BSides-CT/2020-Badge/Hardware/Schematics/bsidesct2019.kicad_pcb

## KiCad design Hardware/Schematics/bsidesct2019.kicad_pcb (2020-11-04)

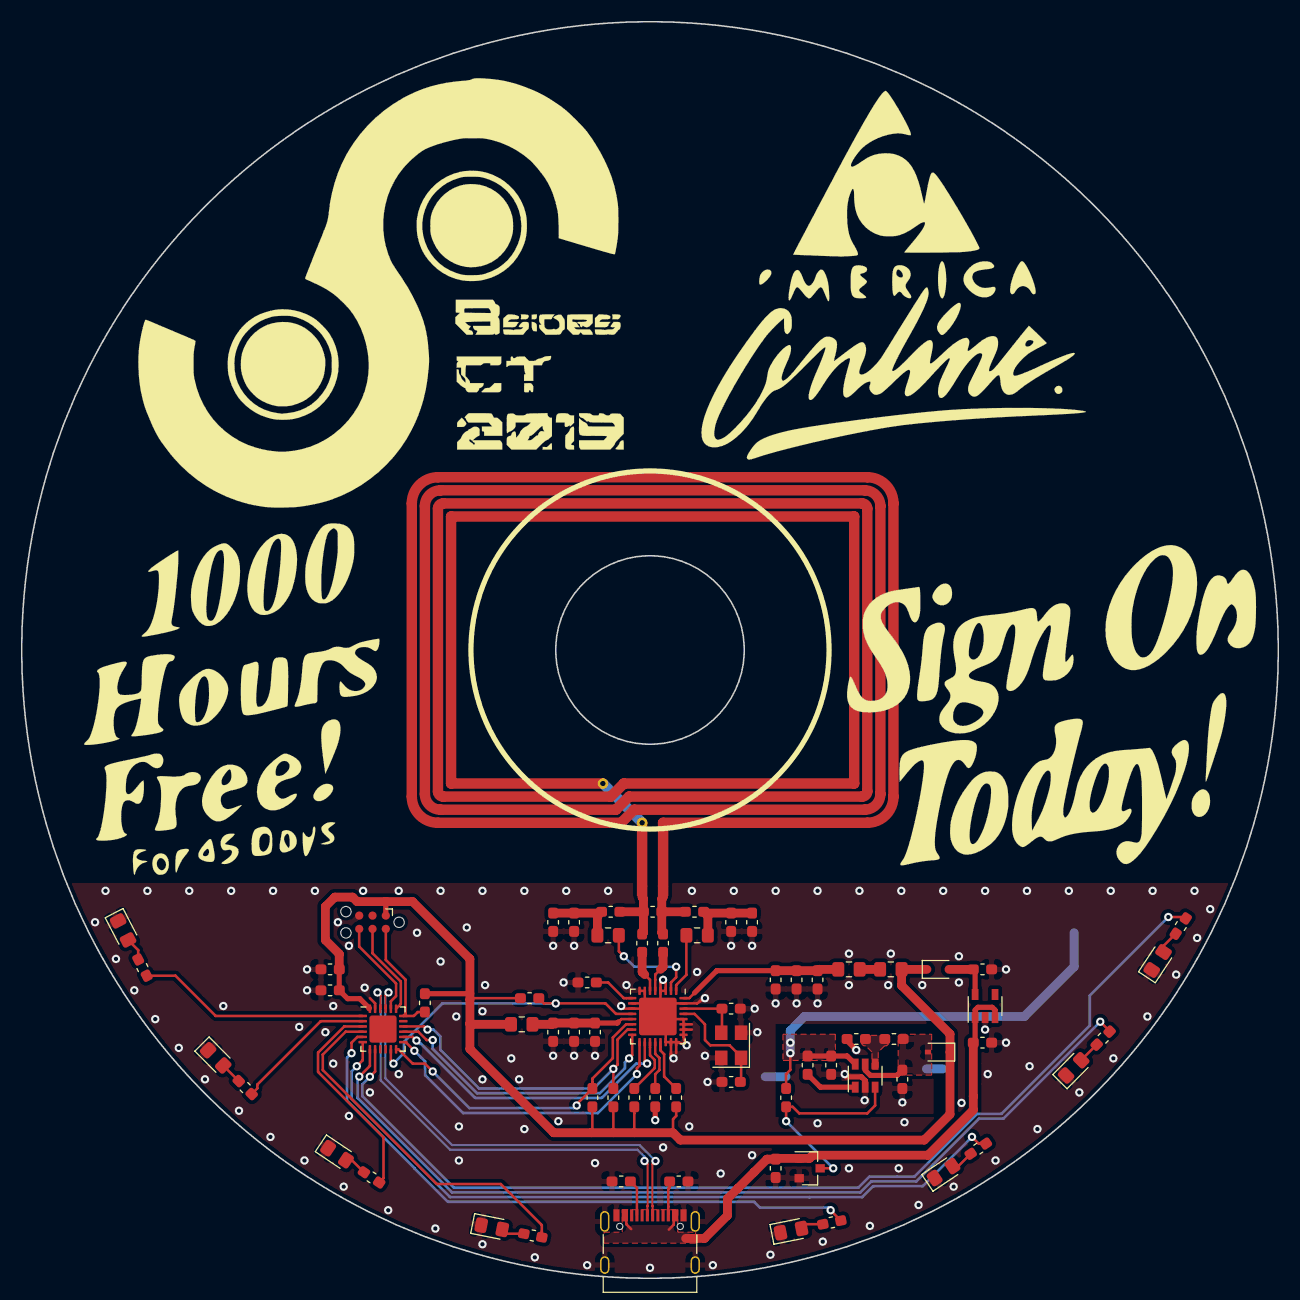
[picture p8: board bsidesct2019.kicad_pcb from above]

Board: 2 copper layers, 120.0 x 120.0 mm, 75 parts (1 on the bottom side), 55 nets.

Parts:
AE1: Antenna; CR95HF-antenna
C1, C2, C18, C21, C22: 1uF; C_0603_1608Metric_Pad1.05x0.95mm_HandSolder
C3, C4, C10: 0.1uF; C_0603_1608Metric_Pad1.05x0.95mm_HandSolder
C5, C9: 10pF; C_0603_1608Metric_Pad1.05x0.95mm_HandSolder
C6, C7: 10nF; C_0603_1608Metric_Pad1.05x0.95mm_HandSolder
C8: 1nF; C_0603_1608Metric_Pad1.05x0.95mm_HandSolder
C11, C12, C13, C14: 100pF; C_0603_1608Metric_Pad1.05x0.95mm_HandSolder
C15, C16: 47pF; C_0603_1608Metric_Pad1.05x0.95mm_HandSolder
C17: 82pF; C_0603_1608Metric_Pad1.05x0.95mm_HandSolder
C19: 4.7uF; C_0603_1608Metric_Pad1.05x0.95mm_HandSolder
C20: 10uF; C_0603_1608Metric_Pad1.05x0.95mm_HandSolder
D1, D10: CUS10S30,H3F; D_SOD-323
D2, D3, D4, D5, D6, D7, D8, D9: LED; LED_0805_2012Metric_Pad1.15x1.40mm_HandSolder
J1: TC2030; Tag-Connect_TC2030-IDC-NL_2x03_P1.27mm_Vertical
L1, L2, L3: 742792042; L_0805_2012Metric_Pad1.15x1.40mm_HandSolder
L4, L5: 560nH; L_0805_2012Metric_Pad1.15x1.40mm_HandSolder
L6: 4.7uH; L_0603_1608Metric_Pad1.05x0.95mm_HandSolder
P1: USB_C_Plug_USB2.0; USB_C_Receptacle_Palconn_UTC16-G
Q1: 2N7002; SOT-23
R1, R2, R3, R4, R5, R15: 3.3kΩ; R_0603_1608Metric_Pad1.05x0.95mm_HandSolder
R6, R7: 330Ω; R_0603_1608Metric_Pad1.05x0.95mm_HandSolder
R8, R13, R14: 10kΩ; R_0603_1608Metric_Pad1.05x0.95mm_HandSolder
R9, R10: 5.1kΩ; R_0603_1608Metric_Pad1.05x0.95mm_HandSolder
R11: 976kΩ; R_0603_1608Metric_Pad1.05x0.95mm_HandSolder
R12: 562kΩ; R_0603_1608Metric_Pad1.05x0.95mm_HandSolder
R16, R17, R18, R19, R20, R21, R22, R23: 260Ω; R_0603_1608Metric_Pad1.05x0.95mm_HandSolder
Ref**: Val**; twitter
Ref**#2: Val**; aol_3
Ref**#3: Val**; aol_2
Ref**#4: Val**; aol_1-merica
Ref**#5: Val**; bsidesct.2019.logo.transparent
U1: CR95HF; QFN-32-1EP_5x5mm_P0.5mm_EP3.6x3.6mm
U2: MCP1640BCH; SOT-23-6
U3: ATSAMD11D14A-M; QFN-24-1EP_4x4mm_P0.5mm_EP2.6x2.6mm
U4: MIC5504-3.3YM5-TR; SOT-23-5
Y1: 27.12MHz; Crystal_SMD_SeikoEpson_FA238V-4Pin_3.2x2.5mm

Connections:
+3V3: C10.1, C18.1, D1.1, D10.1, J1.1, L1.1, L3.1, R1.1, R2.1, R3.1, R5.1, R8.1, R15.1, U3.24
+5V: C21.1, P1.A4, P1.A9, P1.B4, P1.B9, Q1.1, R13.1, U4.1, U4.3
+BATT: C19.1, L6.1, R14.1, U2.6
/D+: P1.A6, U3.22
/D-: P1.A7, U3.21
/L0: R16.2, U3.1
/L1: R17.2, U3.2
/L2: R18.2, U3.3
/L3: R19.2, U3.4
/L4: R20.1, U3.5
/L5: R21.1, U3.6
/L6: R22.1, U3.7
/L7: R23.1, U3.8
/MISO: U1.16, U3.15
/MOSI: U1.17, U3.13
/RX: R3.2, U1.14, U3.12
/SCK: U1.18, U3.14
/SS: R15.2, U1.15, U3.16
/TX: R2.2, U1.12, U3.11
GND: C1.2, C2.2, C3.2, C4.2, C5.2, C6.2, C7.2, C8.1, C9.2, C10.2, C11.2, C12.1, C13.2, C14.1, C18.2, C19.2, C20.2, C21.2, C22.2, D2.1, D3.1, D4.1, D5.1, D6.1, D7.1, D8.1, D9.1, J1.5, P1.A1, P1.A12, P1.B1, P1.B12, P1.S1, Q1.2, R4.1, R9.2, R10.2, R12.2, R13.2, U1.3, U1.4, U1.7, U1.8, U1.10, U1.11, U1.22, U1.23, U1.24, U1.25, U1.26, U1.27, U1.28, U1.31, U1.33, U2.2, U3.23, U4.2, Y1.2, Y1.4
unnamed: AE1.1, C15.2, C17.1, R6.1
unnamed: AE1.2, C16.2, C17.2, R7.1
unnamed: C1.1, C3.1, C6.1, L2.2, U1.32
unnamed: C2.1, C4.1, C7.1, L3.2, U1.13
unnamed: C5.1, U1.29, Y1.1
unnamed: C8.2, U1.9
unnamed: C9.1, U1.30, Y1.3
unnamed: C11.1, C13.1, C15.1, L4.2
unnamed: C12.2, C14.2, C16.1, L5.2
unnamed: C20.1, D1.2, R11.1, U2.5
unnamed: C22.1, D10.2, U4.5
unnamed: D2.2, R16.1
unnamed: D3.2, R17.1
unnamed: D4.2, R18.1
unnamed: D5.2, R19.1
unnamed: D6.2, R20.2
unnamed: D7.2, R21.2
unnamed: D8.2, R22.2
unnamed: D9.2, R23.2
unnamed: J1.2, R8.2, U3.18
unnamed: J1.4, U3.19
unnamed: J1.6, U3.20
unnamed: L1.2, L2.1
unnamed: L4.1, U1.1
unnamed: L5.1, U1.2
unnamed: L6.2, U2.1
unnamed: P1.A5, R9.1
unnamed: P1.B5, R10.1
unnamed: Q1.3, R14.2, U2.3
unnamed: R1.2, U1.19
unnamed: R4.2, U1.20
unnamed: R5.2, U1.21
unnamed: R6.2, U1.5
unnamed: R7.2, U1.6
unnamed: R11.2, R12.1, U2.4
