BSides-CT/2020-Badge/Software/NFCBadge/NFCBadge/driver_init.c

/*
 * Code generated from Atmel Start.
 *
 * This file will be overwritten when reconfiguring your Atmel Start project.
 * Please copy examples or other code you want to keep to a separate file
 * to avoid losing it when reconfiguring.
 */

#include "driver_init.h"
#include <peripheral_clk_config.h>
#include <utils.h>
#include <hal_init.h>
#include <hpl_gclk_base.h>
#include <hpl_pm_base.h>

struct spi_m_sync_descriptor SPI_0;
struct timer_descriptor      TIMER_0;

void EXTERNAL_IRQ_0_init(void)
{
	_gclk_enable_channel(EIC_GCLK_ID, CONF_GCLK_EIC_SRC);

	// Set pin direction to input
	gpio_set_pin_direction(IRQ_IN, GPIO_DIRECTION_IN);

	gpio_set_pin_pull_mode(IRQ_IN,
	                       // <y> Pull configuration
	                       // <id> pad_pull_config
	                       // <GPIO_PULL_OFF"> Off
	                       // <GPIO_PULL_UP"> Pull-up
	                       // <GPIO_PULL_DOWN"> Pull-down
	                       GPIO_PULL_OFF);

	gpio_set_pin_function(IRQ_IN, PINMUX_PA15A_EIC_EXTINT1);

	ext_irq_init();
}

void SPI_0_PORT_init(void)
{

	gpio_set_pin_level(SPI_MISO,
	                   // <y> Initial level
	                   // <id> pad_initial_level
	                   // <false"> Low
	                   // <true"> High
	                   false);

	// Set pin direction to output
	gpio_set_pin_direction(SPI_MISO, GPIO_DIRECTION_OUT);

	gpio_set_pin_function(SPI_MISO, PINMUX_PA22C_SERCOM1_PAD0);

	// Set pin direction to input
	gpio_set_pin_direction(SPI_MOSI, GPIO_DIRECTION_IN);

	gpio_set_pin_pull_mode(SPI_MOSI,
	                       // <y> Pull configuration
	                       // <id> pad_pull_config
	                       // <GPIO_PULL_OFF"> Off
	                       // <GPIO_PULL_UP"> Pull-up
	                       // <GPIO_PULL_DOWN"> Pull-down
	                       GPIO_PULL_OFF);

	gpio_set_pin_function(SPI_MOSI, PINMUX_PA16C_SERCOM1_PAD2);

	gpio_set_pin_level(SPI_SCK,
	                   // <y> Initial level
	                   // <id> pad_initial_level
	                   // <false"> Low
	                   // <true"> High
	                   false);

	// Set pin direction to output
	gpio_set_pin_direction(SPI_SCK, GPIO_DIRECTION_OUT);

	gpio_set_pin_function(SPI_SCK, PINMUX_PA17C_SERCOM1_PAD3);
}

void SPI_0_CLOCK_init(void)
{
	_pm_enable_bus_clock(PM_BUS_APBC, SERCOM1);
	_gclk_enable_channel(SERCOM1_GCLK_ID_CORE, CONF_GCLK_SERCOM1_CORE_SRC);
}

void SPI_0_init(void)
{
	SPI_0_CLOCK_init();
	spi_m_sync_init(&SPI_0, SERCOM1);
	SPI_0_PORT_init();
}

void delay_driver_init(void)
{
	delay_init(SysTick);
}

/**
 * \brief Timer initialization function
 *
 * Enables Timer peripheral, clocks and initializes Timer driver
 */
static void TIMER_0_init(void)
{
	_pm_enable_bus_clock(PM_BUS_APBC, TC1);
	_gclk_enable_channel(TC1_GCLK_ID, CONF_GCLK_TC1_SRC);

	timer_init(&TIMER_0, TC1, _tc_get_timer());
}

void USB_DEVICE_INSTANCE_PORT_init(void)
{

	gpio_set_pin_direction(PA24,
	                       // <y> Pin direction
	                       // <id> pad_direction
	                       // <GPIO_DIRECTION_OFF"> Off
	                       // <GPIO_DIRECTION_IN"> In
	                       // <GPIO_DIRECTION_OUT"> Out
	                       GPIO_DIRECTION_OUT);

	gpio_set_pin_level(PA24,
	                   // <y> Initial level
	                   // <id> pad_initial_level
	                   // <false"> Low
	                   // <true"> High
	                   false);

	gpio_set_pin_pull_mode(PA24,
	                       // <y> Pull configuration
	                       // <id> pad_pull_config
	                       // <GPIO_PULL_OFF"> Off
	                       // <GPIO_PULL_UP"> Pull-up
	                       // <GPIO_PULL_DOWN"> Pull-down
	                       GPIO_PULL_OFF);

	gpio_set_pin_function(PA24,
	                      // <y> Pin function
	                      // <id> pad_function
	                      // <i> Auto : use driver pinmux if signal is imported by driver, else turn off function
	                      // <PINMUX_PA24G_USB_DM"> Auto
	                      // <GPIO_PIN_FUNCTION_OFF"> Off
	                      // <GPIO_PIN_FUNCTION_A"> A
	                      // <GPIO_PIN_FUNCTION_B"> B
	                      // <GPIO_PIN_FUNCTION_C"> C
	                      // <GPIO_PIN_FUNCTION_D"> D
	                      // <GPIO_PIN_FUNCTION_E"> E
	                      // <GPIO_PIN_FUNCTION_F"> F
	                      // <GPIO_PIN_FUNCTION_G"> G
	                      // <GPIO_PIN_FUNCTION_H"> H
	                      PINMUX_PA24G_USB_DM);

	gpio_set_pin_direction(PA25,
	                       // <y> Pin direction
	                       // <id> pad_direction
	                       // <GPIO_DIRECTION_OFF"> Off
	                       // <GPIO_DIRECTION_IN"> In
	                       // <GPIO_DIRECTION_OUT"> Out
	                       GPIO_DIRECTION_OUT);

	gpio_set_pin_level(PA25,
	                   // <y> Initial level
	                   // <id> pad_initial_level
	                   // <false"> Low
	                   // <true"> High
	                   false);

	gpio_set_pin_pull_mode(PA25,
	                       // <y> Pull configuration
	                       // <id> pad_pull_config
	                       // <GPIO_PULL_OFF"> Off
	                       // <GPIO_PULL_UP"> Pull-up
	                       // <GPIO_PULL_DOWN"> Pull-down
	                       GPIO_PULL_OFF);

	gpio_set_pin_function(PA25,
	                      // <y> Pin function
	                      // <id> pad_function
	                      // <i> Auto : use driver pinmux if signal is imported by driver, else turn off function
	                      // <PINMUX_PA25G_USB_DP"> Auto
	                      // <GPIO_PIN_FUNCTION_OFF"> Off
	                      // <GPIO_PIN_FUNCTION_A"> A
	                      // <GPIO_PIN_FUNCTION_B"> B
	                      // <GPIO_PIN_FUNCTION_C"> C
	                      // <GPIO_PIN_FUNCTION_D"> D
	                      // <GPIO_PIN_FUNCTION_E"> E
	                      // <GPIO_PIN_FUNCTION_F"> F
	                      // <GPIO_PIN_FUNCTION_G"> G
	                      // <GPIO_PIN_FUNCTION_H"> H
	                      PINMUX_PA25G_USB_DP);
}

/* The USB module requires a GCLK_USB of 48 MHz ~ 0.25% clock
 * for low speed and full speed operation. */
#if (CONF_GCLK_USB_FREQUENCY > (48000000 + 48000000 / 400)) || (CONF_GCLK_USB_FREQUENCY < (48000000 - 48000000 / 400))
#warning USB clock should be 48MHz ~ 0.25% clock, check your configuration!
#endif

void USB_DEVICE_INSTANCE_CLOCK_init(void)
{

	_pm_enable_bus_clock(PM_BUS_APBB, USB);
	_pm_enable_bus_clock(PM_BUS_AHB, USB);
	_gclk_enable_channel(USB_GCLK_ID, CONF_GCLK_USB_SRC);
}

void USB_DEVICE_INSTANCE_init(void)
{
	USB_DEVICE_INSTANCE_CLOCK_init();
	usb_d_init();
	USB_DEVICE_INSTANCE_PORT_init();
}

void system_init(void)
{
	init_mcu();

	// GPIO on PA02

	gpio_set_pin_level(LED1,
	                   // <y> Initial level
	                   // <id> pad_initial_level
	                   // <false"> Low
	                   // <true"> High
	                   false);

	// Set pin direction to output
	gpio_set_pin_direction(LED1, GPIO_DIRECTION_OUT);

	gpio_set_pin_function(LED1, GPIO_PIN_FUNCTION_OFF);

	// GPIO on PA03

	gpio_set_pin_level(LED2,
	                   // <y> Initial level
	                   // <id> pad_initial_level
	                   // <false"> Low
	                   // <true"> High
	                   false);

	// Set pin direction to output
	gpio_set_pin_direction(LED2, GPIO_DIRECTION_OUT);

	gpio_set_pin_function(LED2, GPIO_PIN_FUNCTION_OFF);

	// GPIO on PA04

	gpio_set_pin_level(LED3,
	                   // <y> Initial level
	                   // <id> pad_initial_level
	                   // <false"> Low
	                   // <true"> High
	                   false);

	// Set pin direction to output
	gpio_set_pin_direction(LED3, GPIO_DIRECTION_OUT);

	gpio_set_pin_function(LED3, GPIO_PIN_FUNCTION_OFF);

	// GPIO on PA05

	gpio_set_pin_level(LED4,
	                   // <y> Initial level
	                   // <id> pad_initial_level
	                   // <false"> Low
	                   // <true"> High
	                   false);

	// Set pin direction to output
	gpio_set_pin_direction(LED4, GPIO_DIRECTION_OUT);

	gpio_set_pin_function(LED4, GPIO_PIN_FUNCTION_OFF);

	// GPIO on PA06

	gpio_set_pin_level(LED5,
	                   // <y> Initial level
	                   // <id> pad_initial_level
	                   // <false"> Low
	                   // <true"> High
	                   false);

	// Set pin direction to output
	gpio_set_pin_direction(LED5, GPIO_DIRECTION_OUT);

	gpio_set_pin_function(LED5, GPIO_PIN_FUNCTION_OFF);

	// GPIO on PA07

	gpio_set_pin_level(LED6,
	                   // <y> Initial level
	                   // <id> pad_initial_level
	                   // <false"> Low
	                   // <true"> High
	                   false);

	// Set pin direction to output
	gpio_set_pin_direction(LED6, GPIO_DIRECTION_OUT);

	gpio_set_pin_function(LED6, GPIO_PIN_FUNCTION_OFF);

	// GPIO on PA08

	gpio_set_pin_level(LED7,
	                   // <y> Initial level
	                   // <id> pad_initial_level
	                   // <false"> Low
	                   // <true"> High
	                   false);

	// Set pin direction to output
	gpio_set_pin_direction(LED7, GPIO_DIRECTION_OUT);

	gpio_set_pin_function(LED7, GPIO_PIN_FUNCTION_OFF);

	// GPIO on PA09

	gpio_set_pin_level(LED8,
	                   // <y> Initial level
	                   // <id> pad_initial_level
	                   // <false"> Low
	                   // <true"> High
	                   false);

	// Set pin direction to output
	gpio_set_pin_direction(LED8, GPIO_DIRECTION_OUT);

	gpio_set_pin_function(LED8, GPIO_PIN_FUNCTION_OFF);

	// GPIO on PA14

	gpio_set_pin_level(IRQ_OUT,
	                   // <y> Initial level
	                   // <id> pad_initial_level
	                   // <false"> Low
	                   // <true"> High
	                   false);

	// Set pin direction to output
	gpio_set_pin_direction(IRQ_OUT, GPIO_DIRECTION_OUT);

	gpio_set_pin_function(IRQ_OUT, GPIO_PIN_FUNCTION_OFF);

	// GPIO on PA23

	gpio_set_pin_direction(SPI_SS,
	                       // <y> Pin direction
	                       // <id> pad_direction
	                       // <GPIO_DIRECTION_OFF"> Off
	                       // <GPIO_DIRECTION_IN"> In
	                       // <GPIO_DIRECTION_OUT"> Out
	                       GPIO_DIRECTION_OUT);

	gpio_set_pin_level(SPI_SS,
	                   // <y> Initial level
	                   // <id> pad_initial_level
	                   // <false"> Low
	                   // <true"> High
	                   true);

	gpio_set_pin_pull_mode(SPI_SS,
	                       // <y> Pull configuration
	                       // <id> pad_pull_config
	                       // <GPIO_PULL_OFF"> Off
	                       // <GPIO_PULL_UP"> Pull-up
	                       // <GPIO_PULL_DOWN"> Pull-down
	                       GPIO_PULL_OFF);

	gpio_set_pin_function(SPI_SS,
	                      // <y> Pin function
	                      // <id> pad_function
	                      // <i> Auto : use driver pinmux if signal is imported by driver, else turn off function
	                      // <GPIO_PIN_FUNCTION_OFF"> Auto
	                      // <GPIO_PIN_FUNCTION_OFF"> Off
	                      // <GPIO_PIN_FUNCTION_A"> A
	                      // <GPIO_PIN_FUNCTION_B"> B
	                      // <GPIO_PIN_FUNCTION_C"> C
	                      // <GPIO_PIN_FUNCTION_D"> D
	                      // <GPIO_PIN_FUNCTION_E"> E
	                      // <GPIO_PIN_FUNCTION_F"> F
	                      // <GPIO_PIN_FUNCTION_G"> G
	                      // <GPIO_PIN_FUNCTION_H"> H
	                      GPIO_PIN_FUNCTION_C);

	EXTERNAL_IRQ_0_init();

	SPI_0_init();

	delay_driver_init();

	TIMER_0_init();

	USB_DEVICE_INSTANCE_init();
}
