BSides-CT/2020-Badge/Software/NFCBadge/NFCBadge/examples/driver_examples.c

/*
 * Code generated from Atmel Start.
 *
 * This file will be overwritten when reconfiguring your Atmel Start project.
 * Please copy examples or other code you want to keep to a separate file
 * to avoid losing it when reconfiguring.
 */

#include "driver_examples.h"
#include "driver_init.h"
#include "utils.h"

static void button_on_PA15_pressed(void)
{
}

/**
 * Example of using EXTERNAL_IRQ_0
 */
void EXTERNAL_IRQ_0_example(void)
{

	ext_irq_register(PIN_PA15, button_on_PA15_pressed);
}

/**
 * Example of using SPI_0 to write "Hello World" using the IO abstraction.
 */
static uint8_t example_SPI_0[12] = "Hello World!";

void SPI_0_example(void)
{
	struct io_descriptor *io;
	spi_m_sync_get_io_descriptor(&SPI_0, &io);

	spi_m_sync_enable(&SPI_0);
	io_write(io, example_SPI_0, 12);
}

void delay_example(void)
{
	delay_ms(5000);
}

static struct timer_task TIMER_0_task1, TIMER_0_task2;

/**
 * Example of using TIMER_0.
 */
static void TIMER_0_task1_cb(const struct timer_task *const timer_task)
{
}

static void TIMER_0_task2_cb(const struct timer_task *const timer_task)
{
}

void TIMER_0_example(void)
{
	TIMER_0_task1.interval = 100;
	TIMER_0_task1.cb       = TIMER_0_task1_cb;
	TIMER_0_task1.mode     = TIMER_TASK_REPEAT;
	TIMER_0_task2.interval = 200;
	TIMER_0_task2.cb       = TIMER_0_task2_cb;
	TIMER_0_task2.mode     = TIMER_TASK_REPEAT;

	timer_add_task(&TIMER_0, &TIMER_0_task1);
	timer_add_task(&TIMER_0, &TIMER_0_task2);
	timer_start(&TIMER_0);
}
