BSides-CT/2020-Badge/Images/adapter.jpg

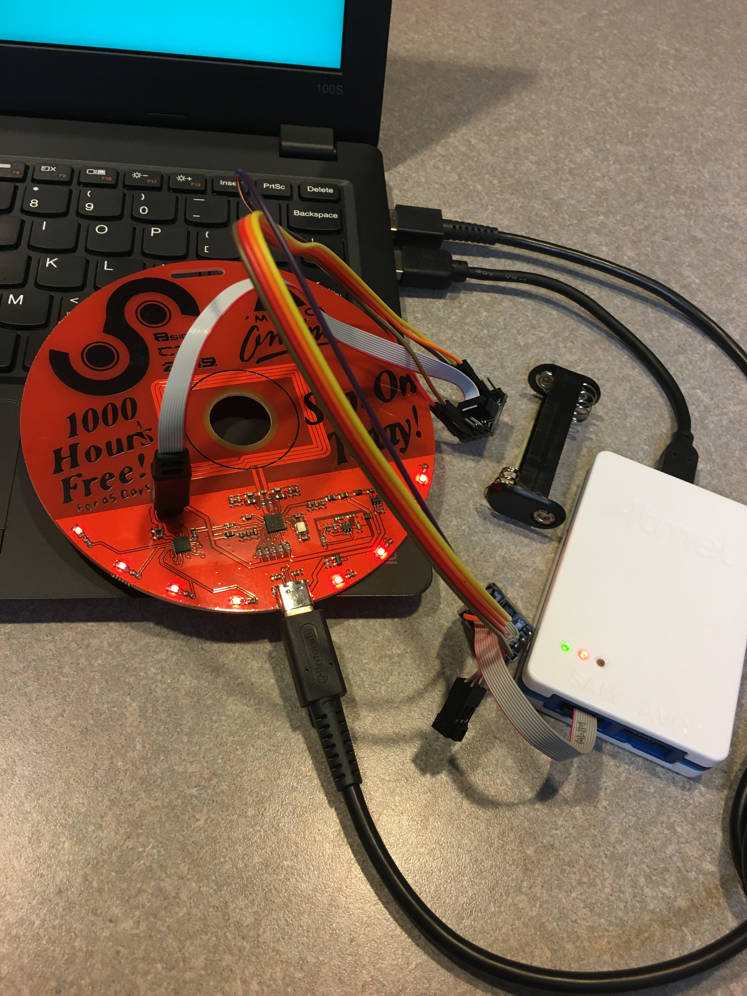
[picture p7: Images/adapter.jpg]
Images/adapter.jpg
